kenneth3132/lfr-trial-1/start_wokwi/connections_and_requirements.txt

========================================================================================================================
                          WOKWI SIMULATION & HARDWARE MASTER CONNECTIONS TABLE
                                          Folder: start_woki
                                     Target Board: Arduino Nano
========================================================================================================================

------------------------------------------------------------------------------------------------------------------------
TABLE 1: 8-CHANNEL ANALOG SENSOR INPUTS (DIRECT NO-MUX ACQUISITION)
------------------------------------------------------------------------------------------------------------------------
+---------------+---------------+-------------------+--------------------+-------------------+-------------------------+
| Sensor Channel| Physical Pos  | Wokwi Part ID     | Arduino Nano Pin   | Signal Type       | Operational Simulation  |
+---------------+---------------+-------------------+--------------------+-------------------+-------------------------+
| Sensor 0      | Far Left      | pot0 (SIG Pin)    | A0                 | Analog In (0-5V)  | Dial CW = Black Line    |
| Sensor 1      | Mid Left-Outer| pot1 (SIG Pin)    | A1                 | Analog In (0-5V)  | Dial CW = Black Line    |
| Sensor 2      | Mid Left-Inner| pot2 (SIG Pin)    | A2                 | Analog In (0-5V)  | Dial CW = Black Line    |
| Sensor 3      | Center Left   | pot3 (SIG Pin)    | A3                 | Analog In (0-5V)  | Dial CW = Black Line    |
| Sensor 4      | Center Right  | pot4 (SIG Pin)    | A4                 | Analog In (0-5V)  | Dial CW = Black Line    |
| Sensor 5      | Mid Rgt-Inner | pot5 (SIG Pin)    | A5                 | Analog In (0-5V)  | Dial CW = Black Line    |
| Sensor 6      | Mid Rgt-Outer | pot6 (SIG Pin)    | A6 (Analog-only)   | Analog In (0-5V)  | Dial CW = Black Line    |
| Sensor 7      | Far Right     | pot7 (SIG Pin)    | A7 (Analog-only)   | Analog In (0-5V)  | Dial CW = Black Line    |
|               |               |                   |                    |                   |                         |
| Sensor VCC    | Common Rail   | pot0-pot7 (VCC)   | 5V Pin             | Regulated Power   | High Rail (5.0V)        |
| Sensor GND    | Common Rail   | pot0-pot7 (GND)   | GND.1 Pin          | System Ground     | Ground Reference (0V)   |
+---------------+---------------+-------------------+--------------------+-------------------+-------------------------+

------------------------------------------------------------------------------------------------------------------------
TABLE 2: MOTOR DRIVER & SIMULATION VISUAL INDICATORS
------------------------------------------------------------------------------------------------------------------------
+-------------------+-------------------+--------------------+------------------+------------------+-------------------+
| Motor Subsystem   | Nano Output Pin   | Wokwi Indicator LED| TB6612FNG Pin    | L298N Module Pin | Action / State    |
+-------------------+-------------------+--------------------+------------------+------------------+-------------------+
| Left Motor FWD    | D2                | led_lf (Green)     | BIN1             | IN3              | HIGH = Forward    |
| Left Motor REV    | D4                | led_lb (Red)       | BIN2             | IN4              | HIGH = Reverse    |
| Left Motor Speed  | D5 (Timer 0 PWM)  | led_lpwm (Yellow)  | PWMB             | EnB              | PWM Duty Cycle    |
|                   |                   |                    |                  |                  |                   |
| Right Motor Speed | D6 (Timer 0 PWM)  | led_rpwm (Yellow)  | PWMA             | EnA              | PWM Duty Cycle    |
| Right Motor FWD   | D7                | led_rf (Green)     | AIN1             | IN1              | HIGH = Forward    |
| Right Motor REV   | D8                | led_rb (Red)       | AIN2             | IN2              | HIGH = Reverse    |
|                   |                   |                    |                  |                  |                   |
| Driver Standby    | 5V Rail           | (Tied High)        | STBY             | N/A (Jumpered)   | 5V Driver Active  |
| Driver Motor Power| Battery (+)       | (External LiPo)    | VM               | 12V / VS         | 7.4V - 11.1V Raw  |
| Driver Logic VCC  | 5V Rail           | (Nano 5V)          | VCC              | 5V / VSS         | 5.0V Logic Rail   |
| Driver GND        | Common GND        | GND.1 / GND.2      | GND              | GND              | Star Ground Plane |
+-------------------+-------------------+--------------------+------------------+------------------+-------------------+

------------------------------------------------------------------------------------------------------------------------
TABLE 3: USER INPUTS, PUSH BUTTONS & SYSTEM STATUS
------------------------------------------------------------------------------------------------------------------------
+-------------------+-------------------+--------------------+------------------+--------------------------------------+
| Control Element   | Nano Input Pin    | Wokwi Component    | Pin Mode         | Action Triggered on Press            |
+-------------------+-------------------+--------------------+------------------+--------------------------------------+
| Button 1 (START)  | D11               | btn_start (Green)  | INPUT_PULLUP     | Launches Continuous PID Line Follow  |
| Button 1 Ground   | GND.2             | btn_start (Leg 2)  | Ground Reference | Active-LOW (0V) when pressed         |
|                   |                   |                    |                  |                                      |
| Button 2 (CALIB)  | D12               | btn_calib (Blue)   | INPUT_PULLUP     | Triggers 4-Sweep Auto-Calibration    |
| Button 2 Ground   | GND.2             | btn_calib (Leg 2)  | Ground Reference | Active-LOW (0V) when pressed         |
|                   |                   |                    |                  |                                      |
| Status / Turn LED | D13               | led_status (Blue)  | Digital Output   | Turns ON during 90° Turn & Calib     |
+-------------------+-------------------+--------------------+------------------+--------------------------------------+

------------------------------------------------------------------------------------------------------------------------
TABLE 4: SIMULATION HARDWARE & SOFTWARE REQUIREMENTS
------------------------------------------------------------------------------------------------------------------------
1. SIMULATION ENVIRONMENT:
   - Platform: Wokwi Online Simulator (https://wokwi.com) or VS Code Wokwi Extension.
   - Target Board: Arduino Nano (ATmega328P, 16MHz).
   - Baud Rate: 115200 Baud (match in Serial Monitor window).

2. PHYSICAL ROBOT EQUIVALENTS:
   - Sensors: 8x TCRT5000 IR reflectance sensors or Pololu QTR-8A module.
   - Dual Motor Driver: TB6612FNG (recommended for low voltage drop) or L298N.
   - DC Motors: 2x N20 Micro Metal Gearmotors (6V, 500-1000 RPM).
   - Battery: 7.4V (2S) or 11.1V (3S) LiPo (450mAh - 850mAh).
   - Power Filtering: 470uF to 1000uF electrolytic capacitor across driver VM and GND.
   - Push Buttons: 2x 6x6mm momentary tactile switches.

========================================================================================================================
                                     END OF WOKWI REQUIREMENTS & CONNECTIONS
========================================================================================================================
