kenneth3132/lfr-trial-1/Part-10 Files/1.jpg

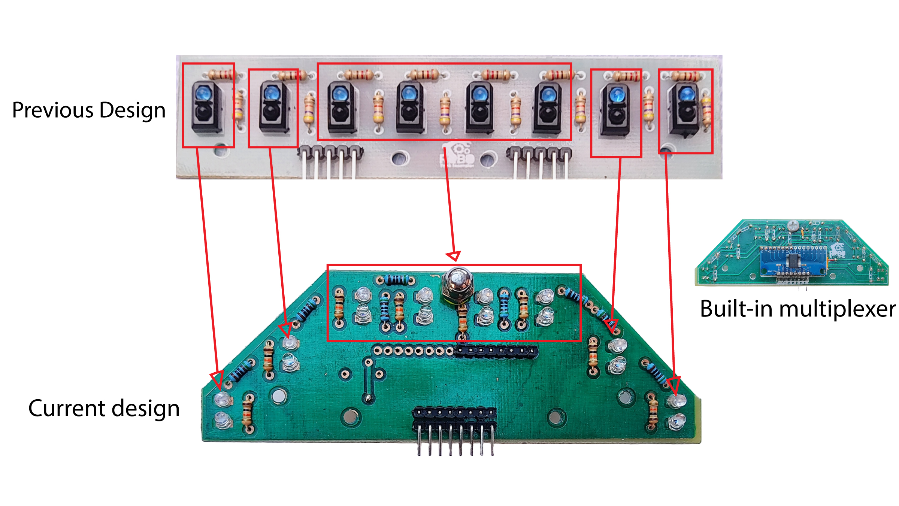
Part-10 Files/1.jpg
