kenneth3132/lfr-trial-1/Part-10 Files/Sensor Connection.jpg

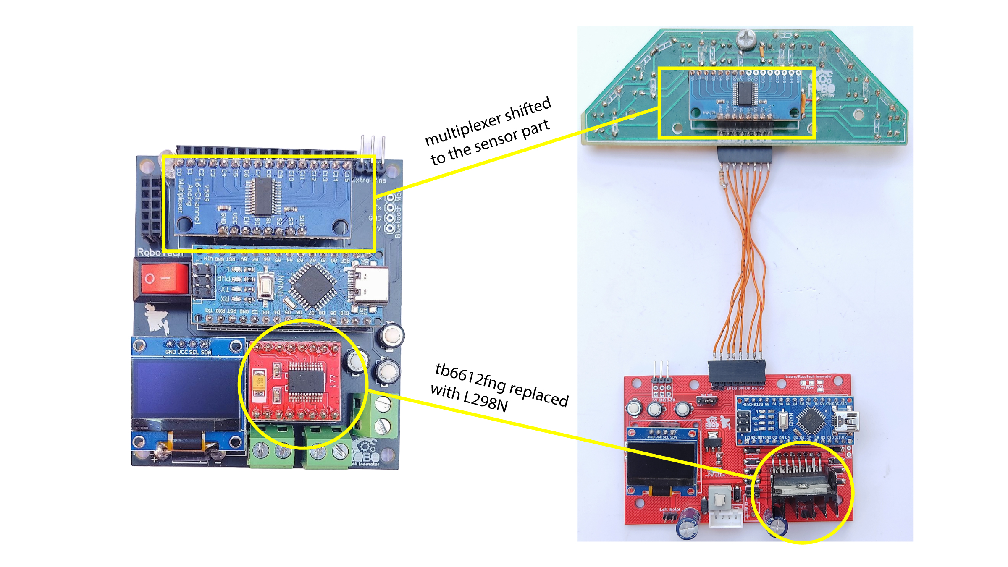
Part-10 Files/Sensor Connection.jpg
