kenneth3132/lfr-trial-1/Part-11 Files/Steps.pdf

## List of Components Required

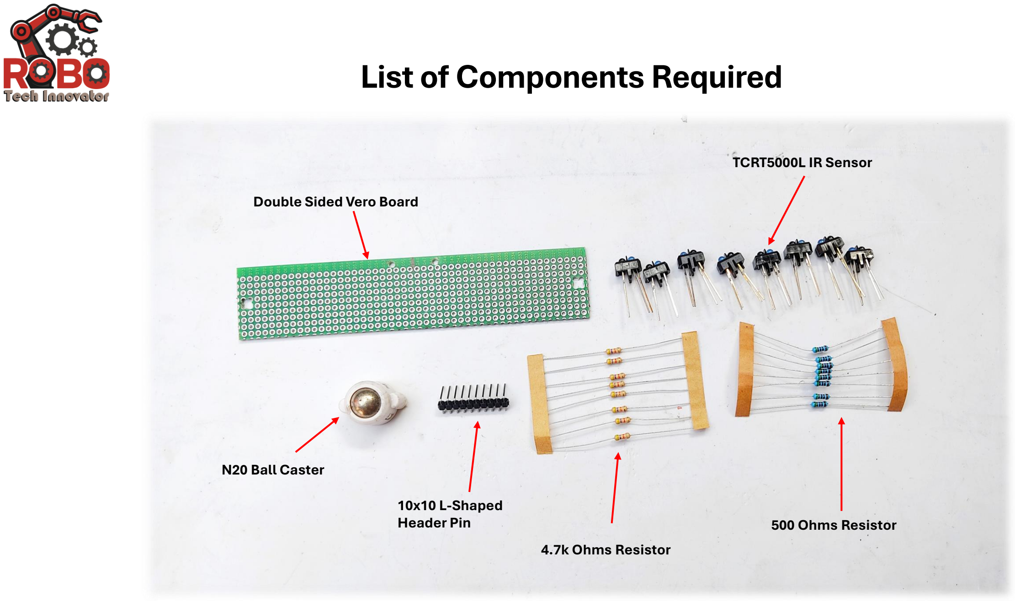
[picture p10: page 1]

Double Sided Vero Board

TCRT5000L IR Sensor

N20 Ball Caster

10x10 L-Shaped
Header Pin
4.7k Ohms Resistor

500 Ohms Resistor

Top View | Bottom View

## TCRT5000L Pinout

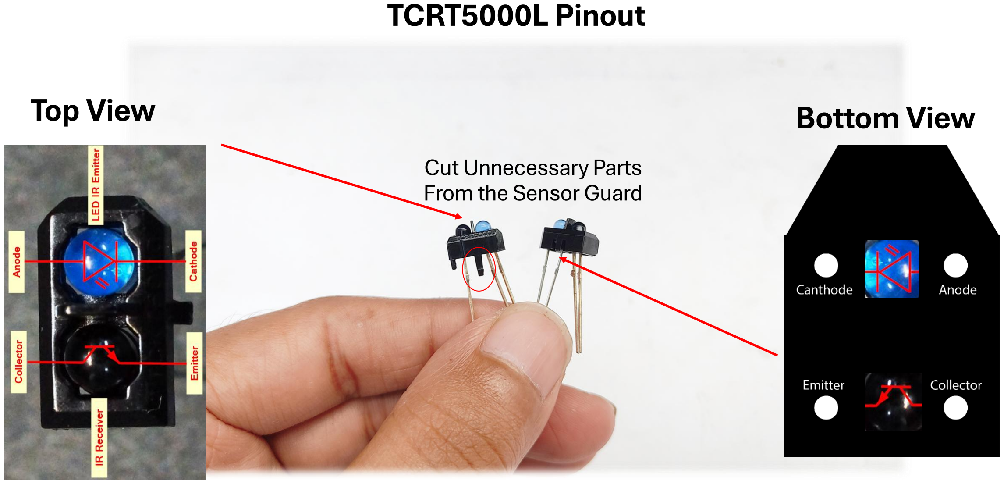
[picture p11: page 2]

Cut Unnecessary Parts
From the Sensor Guard

Top View | Bottom View TCRT5000L Pinout

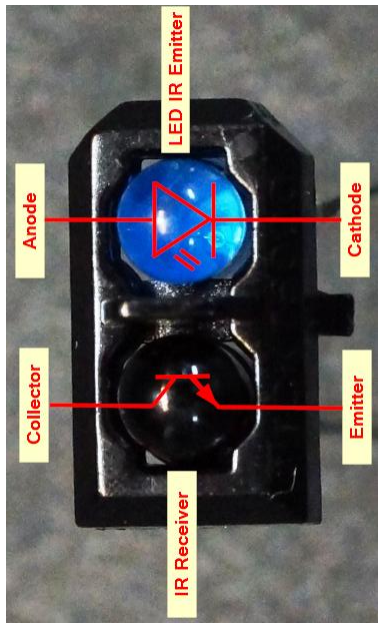
[picture p12: figure]
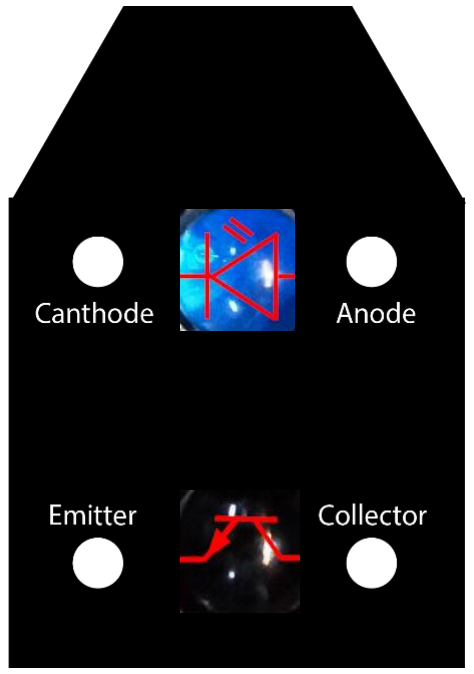
[picture p13: figure]
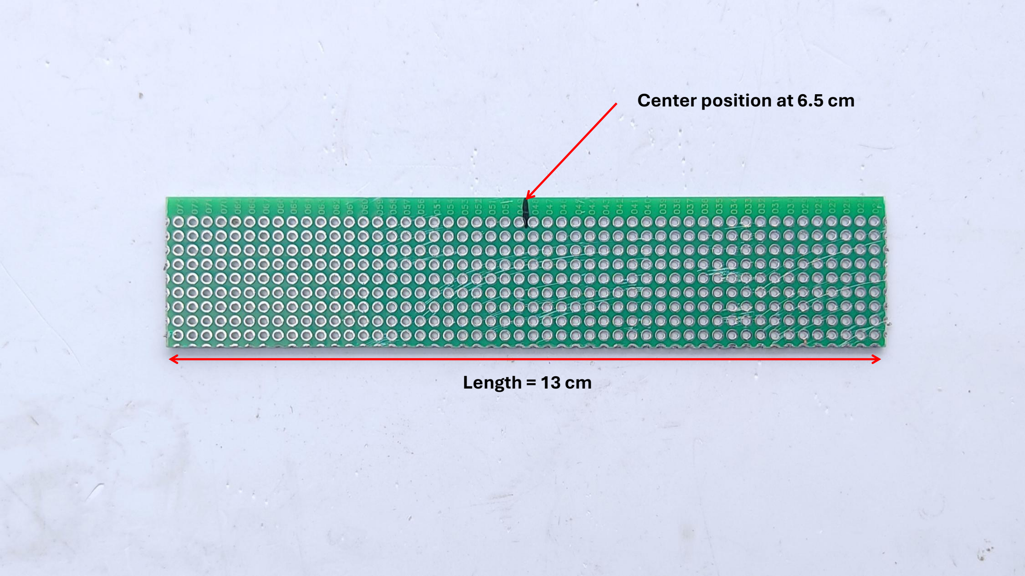
[picture p14: page 4]

Length = 13 cm

Center position at 6.5 cm

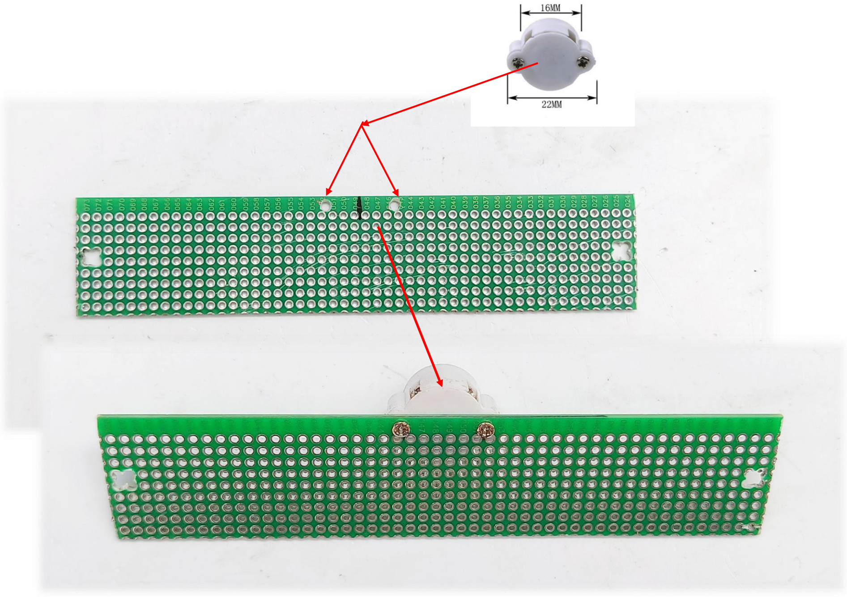
[picture p15: page 5]
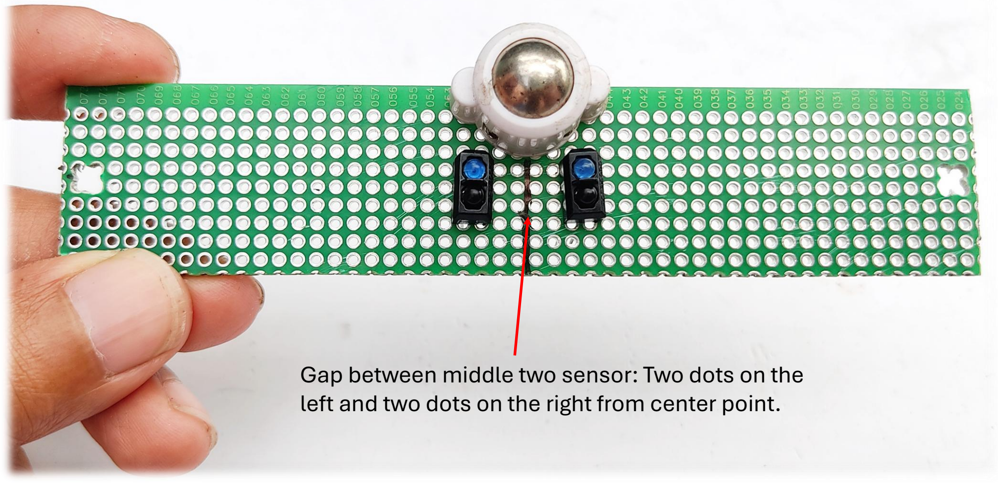
[picture p16: page 6]

Gap between middle two sensor: Two dots on the left and two dots on the right from center point.

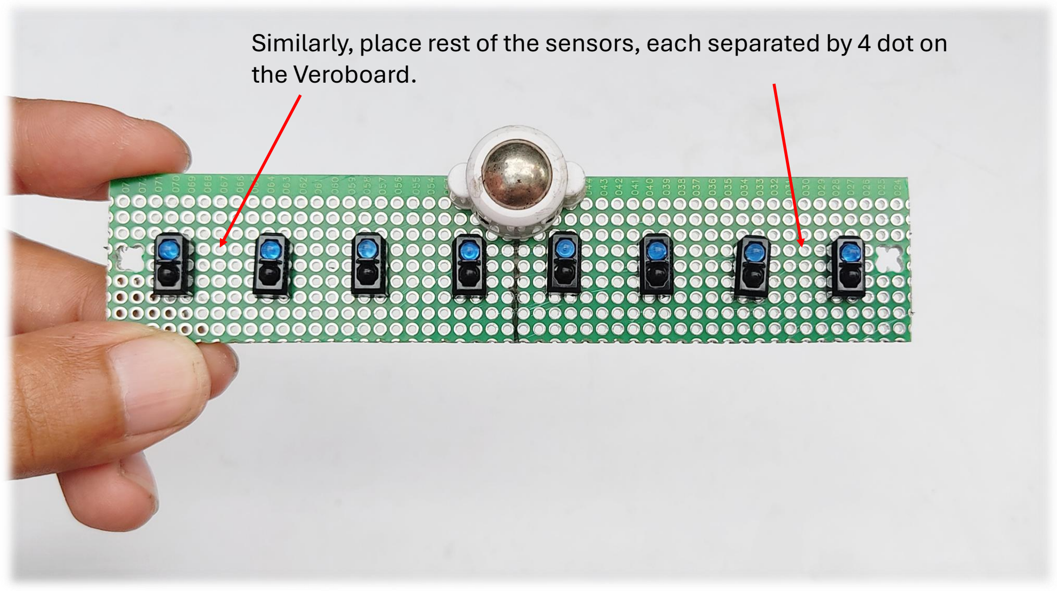
[picture p17: page 7]

Similarly, place rest of the sensors, each separated by 4 dot on the Veroboard.

## After Soldering all the sensors with Veroboard

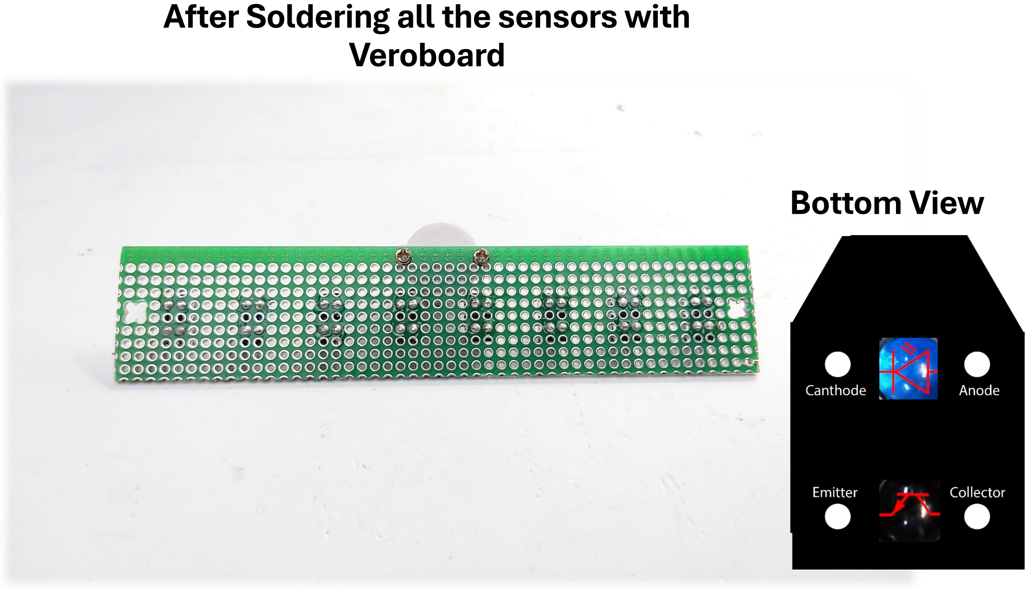
[picture p18: page 8]

## Bottom View

## Connect all Cathode of IR transmitter and all emitter of IR receiver together (will be connected to ground at the end)

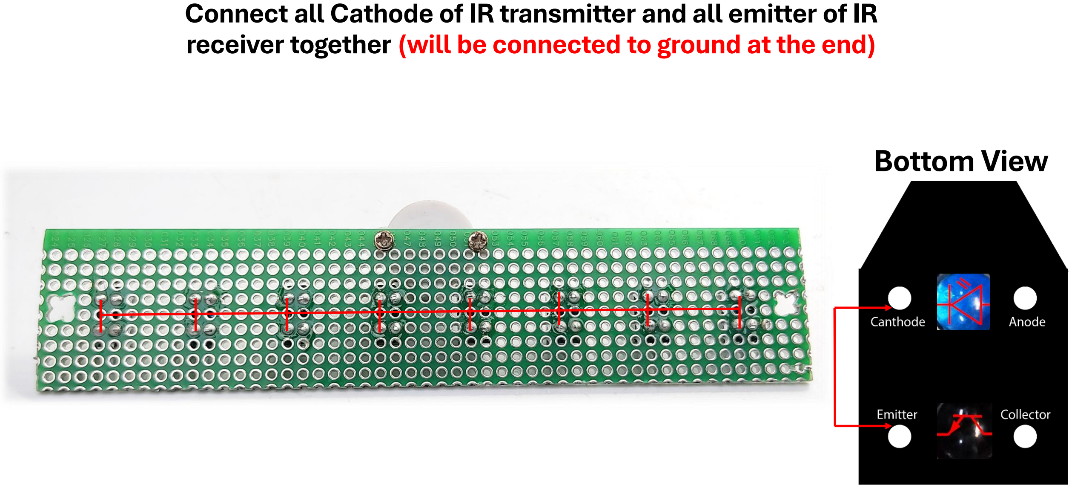
[picture p19: page 9]

## Bottom View

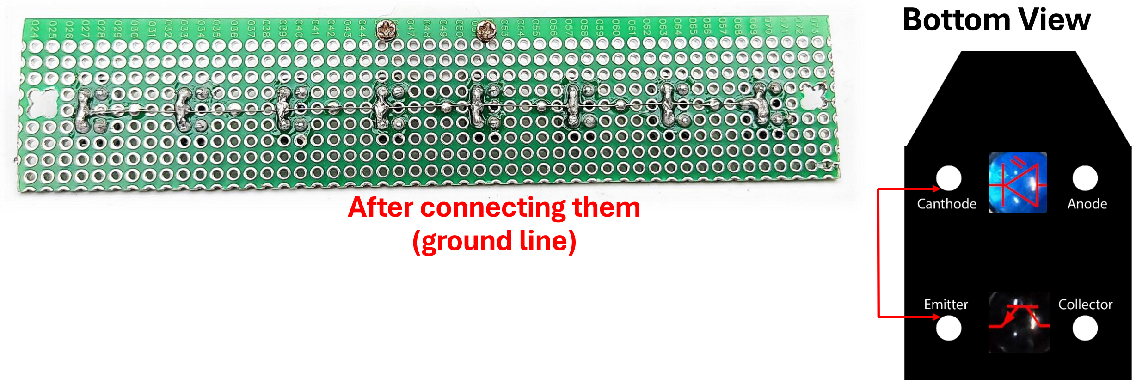
[picture p20: page 10]

## Bottom View

## After connecting them (ground line)

# Connect the anode of all the transmitter-IR leds one by one with Vcc by 500 ohms resistor. This will

power up the IR led to emit IR-rays towards the surface.

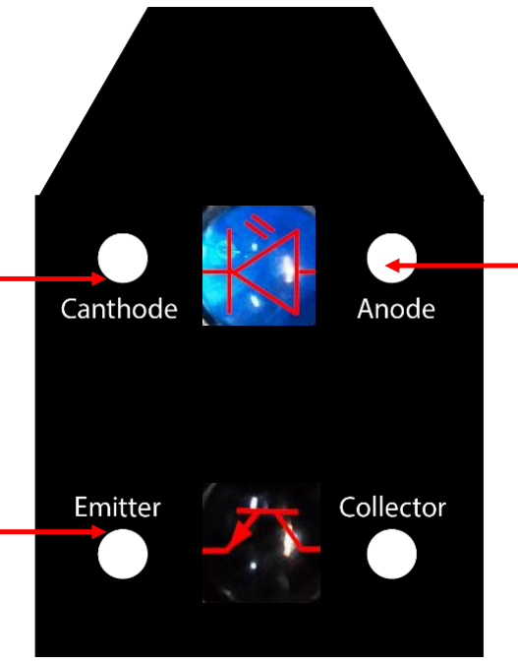
[picture p21: figure]

500 ohms

## Bottom View

## Connect the anode of all the transmitter IR leds

with Vcc by a 500 ohms resistor.

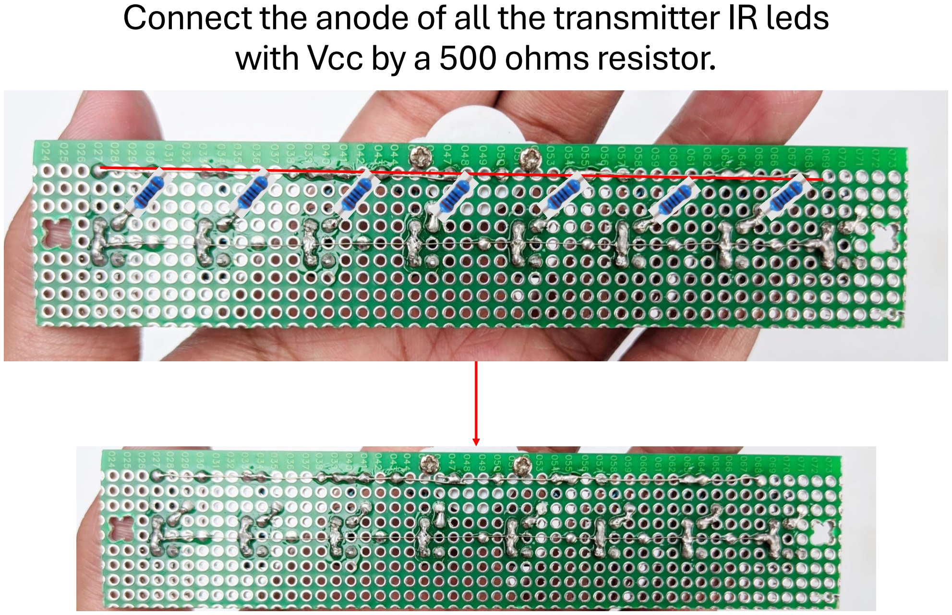
[picture p22: page 12]

# Connect the collector of all receiver

one by one with Vcc by 4.7k ohms resistor.

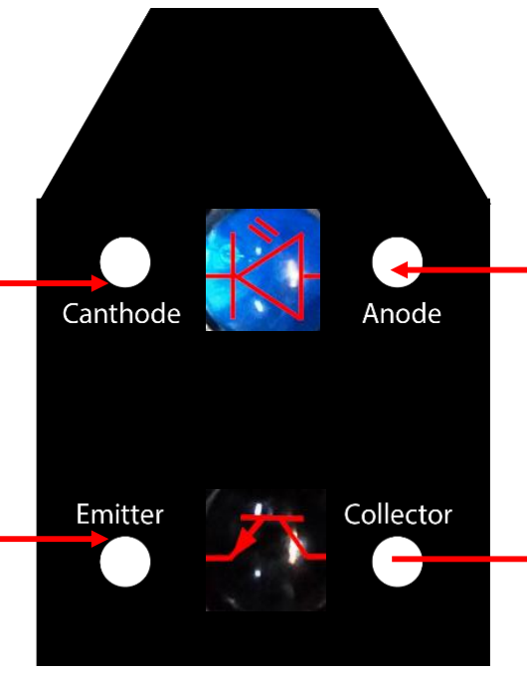
[picture p23: figure]

500 ohms

## Bottom View

4.7k ohms

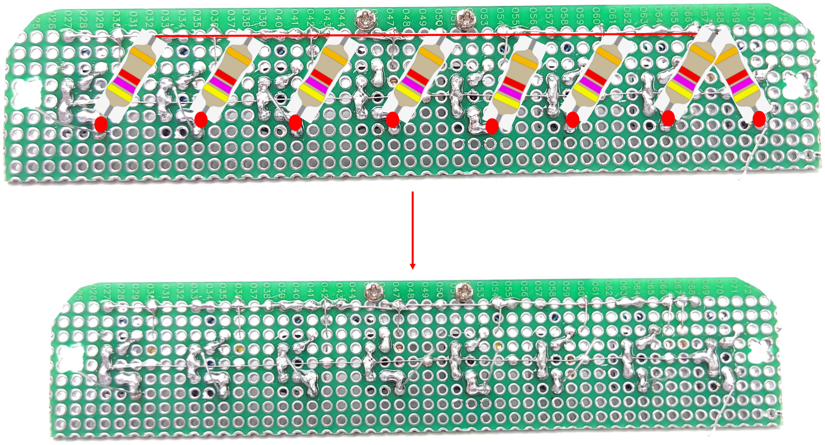
[picture p24: page 14]

# Signal output will be taken from collector of receiver

500 ohms

## Bottom View

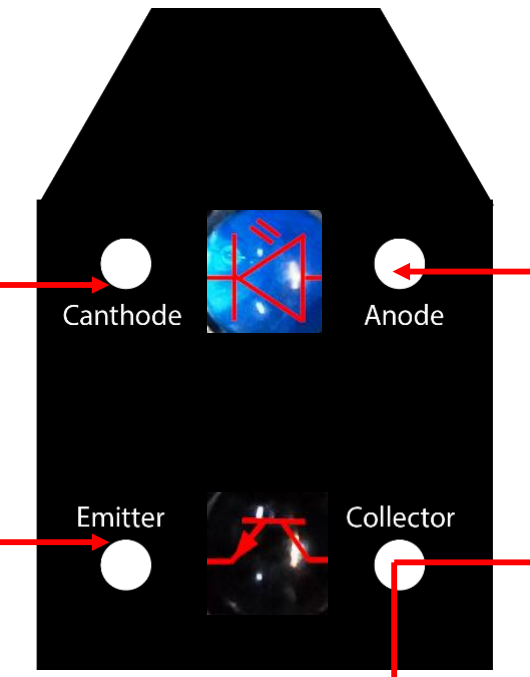
[picture p25: figure]

Signal Output from
Collector of receiver

4.7k ohms

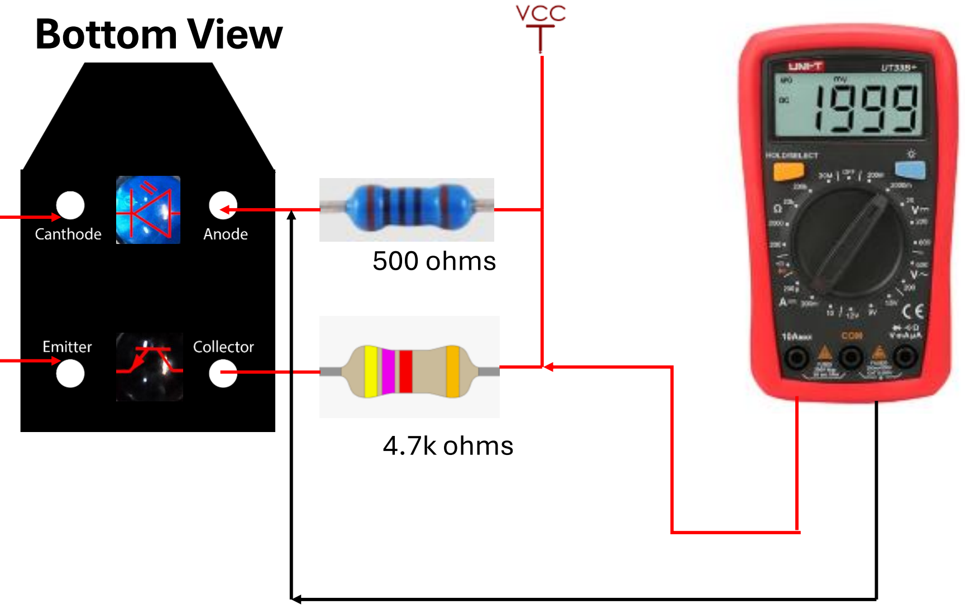
[picture p26: figure]
500 ohms; Bottom View; 4.7k ohms
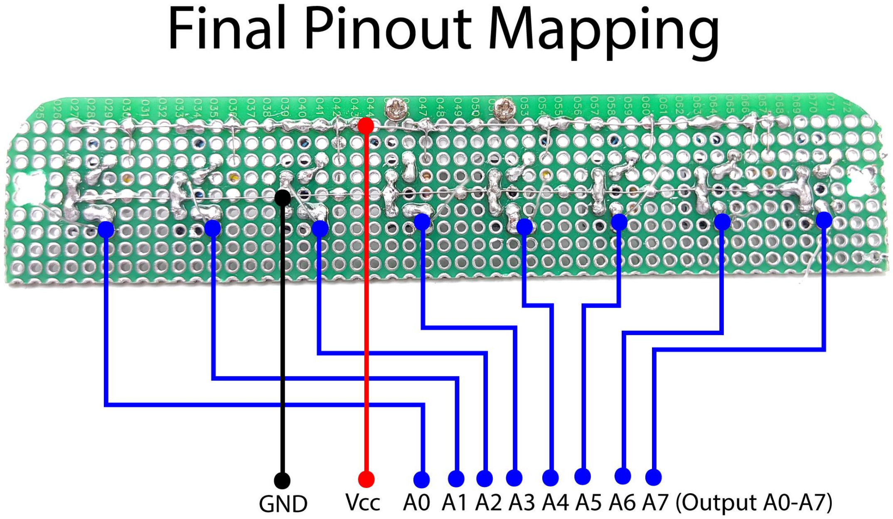
[picture p27: page 17]

# Final Top and Bottom Side

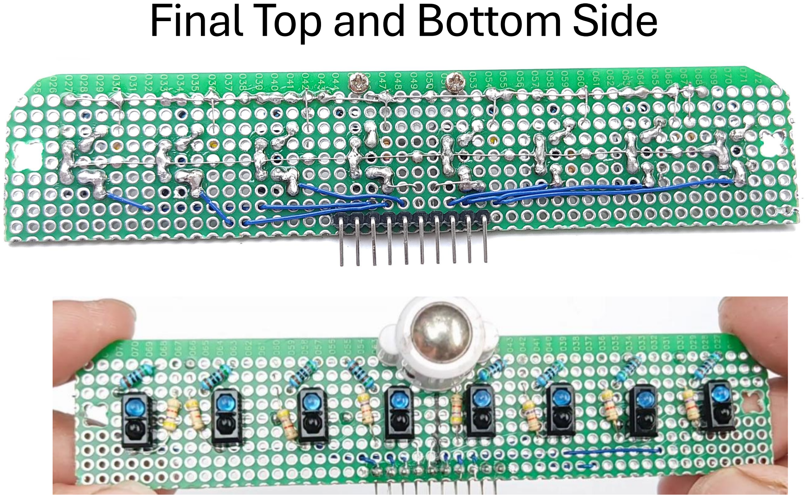
[picture p28: page 18]
