kenneth3132/lfr-trial-1/(list of files, drawings)

Other design files:
Part-03 Files/Proteus Simulation/motor_simulation_proteus.pdsprj
