kenneth3132/lfr-trial-1/Part-05 Files/8IR_MUX_PID_Turns/8IR_MUX_PID_Turns/8IR_MUX_PID_Turns/8IR_MUX_PID_Turns.ino

/*
Contact with Us for any issue:
𝑬-𝒎𝒂𝒊𝒍: aslamhshakil20@gmail.com
𝑭𝒂𝒄𝒆𝒃𝒐𝒐𝒌: https://www.facebook.com/aslamhossain3852
𝑾𝒉𝒂𝒕'𝒔 𝑨𝒑𝒑: https://wa.me/c/8801647467658
𝑻𝒆𝒍𝒆𝒈𝒓𝒂𝒎: https://t.me/+NmZDetFcTvA0MGU1
𝐈𝐧𝐬𝐭𝐚𝐠𝐫𝐚𝐦: https://www.instagram.com/robotech_innovator?igsh=dHUzNTBtajcyNnJv

To get all the LFR related parts/components
knock us through the link: https://wa.me/c/8801647467658

*/



//motorpins
#define right_motor_forward 2   //IN1(L298) || TB6612 -- AIN2
#define right_motor_backward 4  //IN2(L298) || TB6612 -- AIN1
#define left_motor_forward 5    //IN3(L298)  || TB6612 --- BIN1
#define left_motor_backward 6   //IN4(L298)  || TB6612 --- BIN2
//speed control pins (PWM)
#define right_motor_speed 3  //EnA (L298) //TB6612 --- PWMA
#define left_motor_speed 9   //EnB (L298) //TB6612 --- PWMB

//MUX PIN
#define S0 11
#define S1 10
#define S2 8
#define S3 7
#define SIG_PIN A7

//Sensor Variables
#define sensorNumber 8
int sensorADC[sensorNumber];
int sensorDigital[sensorNumber];
int bitWeight[sensorNumber] = { 1, 2, 4, 8, 16, 32, 64, 128 };
int WeightValue[sensorNumber] = { 10, 20, 30, 40, 50, 60, 70, 80 };
int theshold = 500;
int sumOnSensor;
int sensorWight;
int bitSensor;

//PID Variables
float line_position;
float error;
float center_position = 45;
float derivative, previous_error;
int base_speed = 255;
int kp = 8;
int kd = 100;
//turns variable
String direction = "straight";  //default value straight
#define delay_before_turn 100
#define turnSpeed 80


//button
#define button1 A0
#define button2 A1
#define button3 12
//led
#define led 13

//************************************SETUP***************************************
void setup() {
  Serial.begin(9600);
  pinMode(S0, OUTPUT);
  pinMode(S1, OUTPUT);
  pinMode(S2, OUTPUT);
  pinMode(S3, OUTPUT);
  pinMode(button1, INPUT_PULLUP);
  pinMode(button2, INPUT_PULLUP);
  pinMode(button3, INPUT_PULLUP);
  pinMode(led, OUTPUT);

  pinMode(left_motor_forward, OUTPUT);
  pinMode(left_motor_backward, OUTPUT);
  pinMode(right_motor_forward, OUTPUT);
  pinMode(right_motor_backward, OUTPUT);

  pinMode(left_motor_speed, OUTPUT);
  pinMode(left_motor_speed, OUTPUT);
}


//************************************LOOP***************************************
void loop() {
  if (digitalRead(button1) == 0) {  //when button 1 is pressed
    while (1) {
      analog_value_check();
    }
  }
  if (digitalRead(button2) == 0) {  //when button 2 is pressed
    while (1) {
      motor(255, 255);
      //PID_Controller(base_speed, kp, kd);
    }
  }
}
