kenneth3132/lfr-trial-1/(commit log)

2026-11-06 Add connections.txt master wiring and pinout table
2026-11-08 Add Combined_Part1_to_Part8_NoMUX_Fixed with button diagnostics and safety controls, remove duplicate start_woki
2026-11-11 Add Arduino Nano firmware upload and operating guide
